CircuitCo/WL1835MOD/README

The BeagleBone WL1835MOD W/ CHIP ANTENNA is an add-on board that provides Wi-Fi and Bluetooth® capability for the BeagleBone. This cape is equipped with Texas Instrument's WL835MOD pre-certified module. It offers advanced WiFi features including 2.4-GHz MRC Support for Extended Range, 2x2 MIMO and 40-MHz Channels for High Throughput, Wi-Fi Direct Concurrent Operation (Multi-Channel, Multi-Role) and SmartConfig technology. It also supports Bluetooth 4.0 including Bluetooth and BLE and Built-In coexistence technology for Bluetooth-BLE and WLAN. A Royalty-Free Certified Bluetooth Stack From StoneStreet One is also available from TI. This cape has on-board antenna.
