CircuitCo/WL1835MOD/BeagleBone-WL1835MOD-RevA1-bom.xlsx

BeagleBone WIFI Cape COVER PAGE Revised: Thursday, September 26, 2013
009-0003898 Revision: A1
Bill Of Materials September 26,2013 10:47:50
Item | Quantity | Reference | CCO_NUMBER | Part | NAME | VALUEA | VOLTAGE | CURRENT | ACTUAL PCB Footprint | INSTALLED | NEW CCO_NUMBER | COMP. FOOTPRINT
1 | 40 | R4,R5,R6,R7,R8,R9,R10,R11,R12,R13,R14,R21,R23,R24,R25,R26,R27,R28,R29,R30,R34,R35,R36,R37,R38,R39,R40,R41,R42,R43,R55,R56,R57,R59,R60,R61,R74,R75,R78,R79 | 110-0001853 | 0 | 0 |  |  |  | 0402
2 | 7 | R15,R16,R17,R18,R19,R20,R70 | 110-0001879 | 10K | 10K |  |  |  | 0402
3 | 2 | R45,R46 | 110-0001904 | 150K | 150K |  |  |  | 0402
4 | 1 | R32 | 110-0001908 | 150 | 150 |  |  |  | 0402
5 | 4 | R22,R53,R58,R64 | 110-0001926 | 1K0 | 1K0 |  |  |  | 0402
6 | 2 | R71,R72 | 110-0001936 | 1.5K | 1.5K |  |  |  | 0402
7 | 1 | R51 | 110-0001945 | 1M | 1M |  |  |  | 0402
8 | 3 | R63,R68,R69 | 110-0002067 | 4.75K | 4.75K |  |  |  | 0402
9 | 1 | R31 | 110-0002659 | 390 | 390 |  |  |  | 0402
10 | 2 | R66,R67 | 110-0003095 | 0.01R | 0.01R |  |  |  | 0805
11 | 1 | R65 | 110-0003888 | 4.12K | 4.12K |  |  |  | 0402
12 | 1 | R73 | 110-0003934 | 7.15K | 7.15K |  |  |  | 0402
13 | 1 | C12 | 123-0001039 | 10nF | 10nF |  | 50V | c0402 | c0805 | change | 123-0001120 | c0603
14 | 7 | C3,C4,C7,C8,C13,C14,C20 | 123-0001053 | 100nF | 100nF |  | 16V | c0402 | c0805 | change | 123-0001155 | c0805
15 | 3 | C16,C17,C19 | 123-0001128 | 10uF | 10uF |  | 6.3V | c0603 | c0805 | change | 123-0001167 | c0805
16 | 2 | C11,C18 | 123-0001135 | 1uF | 1uF |  | 25V | c0603 | c0805 | change | 123-0001170 | c0805
17 | 2 | C9,C10 | 123-0001147 | 4.7uF | 4.7uF |  | 6.3V | c0603 | c0805 | change | 123-0001180 | c0805
18 | 1 | C15 | 123-0001163 | 10uF | 10uF |  | 25V |  | c0805
19 | 2 | C2,C24 | 123-0003894 | 2.2pF | 2.2pF |  | 25V |  | c0201
20 | 2 | C5,C22 | 123-0003896 | 10pF | 10pF |  | 25V |  | c0201
21 | 2 | L1,L2 | 125-0003895 | 1.5nH | 1.5nH |  |  |  | IND_0402
22 | 1 | FB1 | 126-0001419 | 220 OHMS | 220 OHMS |  |  |  | 0603
23 | 2 | ANT1,ANT2 | 129-0003710 | ANT016008LCD2442MA1 | ANT016008LCD2442MA1 |  |  |  | ANT4_0603
24 | 1 | D1 | 130-0001383 | BAT54 | BAT54 |  |  |  | SOT23_13
25 | 1 | LED1 | 131-0001749 | VLMW1300-GS08 | VLMW1300-GS08 |  | 2.93V |  | LED_0805-1
26 | 1 | LED2 | 131-0001751 | LTST-C170TBKT | LTST-C170TBKT |  | 3.3V |  | LED_0805-1
27 | 2 | Q1,Q2 | 132-0002271 | FDV301N | FDV301N |  |  |  | SOT23_GSD
28 | 1 | U5 | 140-0001558 | CAT24C256W | CAT24C256W |  |  |  | SOIC_8
29 | 1 | U4 | 140-0001627 | TL1963A | TL1963A |  |  |  | dcq-25x85-5
30 | 2 | U1,U2 | 140-0003695 | TXS0108E | TXS0108E |  |  |  | TSSOP-20
31 | 1 | M1 | 140-0003698 | WL1835SAM | WL1835SAM |  |  |  | LGA64_13P3X13P4_P7MM
32 | 1 | U3 | 140-0003703 | TPS73618DBVR | TPS73618DBVR |  |  |  | SOT23-5
33 | 1 | OSC1 | 146-0001794 | OSC/32.768kHz | OSC/32.768kHz |  |  |  | XTAL4_3P2X2P5_SMD
34 | 1 | S1 | 150-0002240 | SW DIP-2 | SW DIP-2 |  |  |  | swdip4_100-339smd
35 | 2 | J8,J9 | 235-0002219 | FEMALE HEADER 2x23 | FEMALE HEADER 2x23 |  |  |  | HEADER23X2
36 | 2 | J10,J12 | 258-0001313 | JUMPER | JUMPER |  |  |  | SIP2
37 | 1 | TC1 | 355-0002506 | TEST_CLIP | TEST_CLIP |  |  |  | TP135X185R_SMD
999 | 21 | R2,R3 R62,R33,R49,R52,R54,R76,R77,R1,C1,C23,C6,C21,J2,J14,J11,J6,J7,J13,J1 | NOT_USED |  |  |  |  |  |  | DNI
DNI PARTS
Item | Quantity | Reference | CCO_NUMBER | Part | NAME | VALUEA | VOLTAGE | CURRENT | PCB Footprint | INSTALLED
1 | 3 | R2,R3,R62 | 110-0001853 | 0 | 0 |  |  |  | 0402 | DNI
2 | 6 | R33,R49,R52,R54,R76,R77 | 110-0001926 | 1K0 | 1K0 |  |  |  | 0402 | DNI
3 | 1 | R1 | 110-0002833 | 10K | 10K |  |  |  | 0805 | DNI
4 | 2 | C1,C23 | 123-0003894 | 2.2pF | 2.2pF |  | 25V |  | c0201 | DNI
5 | 2 | C6,C21 | 123-0003896 | 10pF | 10pF |  | 25V |  | c0201 | DNI
6 | 2 | J2,J14 | 158-0001277 | U.FL-R-SMT-1 | U.FL-R-SMT-1 |  |  |  | COAX3UP_2P6SQ_SMD | DNI
7 | 1 | J11 | 258-0001299 | HDR3 | HDR3 |  |  |  | SIP3 | DNI
8 | 2 | J6,J7 | 258-0001312 | HDR5 | HDR5 |  |  |  | SIP5 | DNI
9 | 1 | J13 | 258-0001313 | JUMPER | JUMPER |  |  |  | SIP2 | DNI
10 | 1 | J1 | 258-0003534 | HDR7 | HDR7 |  |  |  | SIP7 | DNI
 | 21
