CircuitCo/WL1835MOD/(list of files, drawings)

Other design files:
BeagleBone-WL1835MOD-RevA1-schematic.dsn
